hieu0902/Audio-Amplifier/README.md

# Audio-Amplifier
Purpose: Design and build an audio amplifier \\
The audio signal is input into the electrical circuit through a jack plug, and after passing through the electrical circuit, the sound is amplified and transmitted to users through the speaker.
