hieu0902/Audio-Amplifier/(list of files, drawings)

Other design files:
KhuechDaiAmThanh-Dung.PrjPcb
PCB.PcbDoc
Schematic.SchDoc
